chiva/Siguelineas/documentacion/imagenes/big/primerplano.JPG

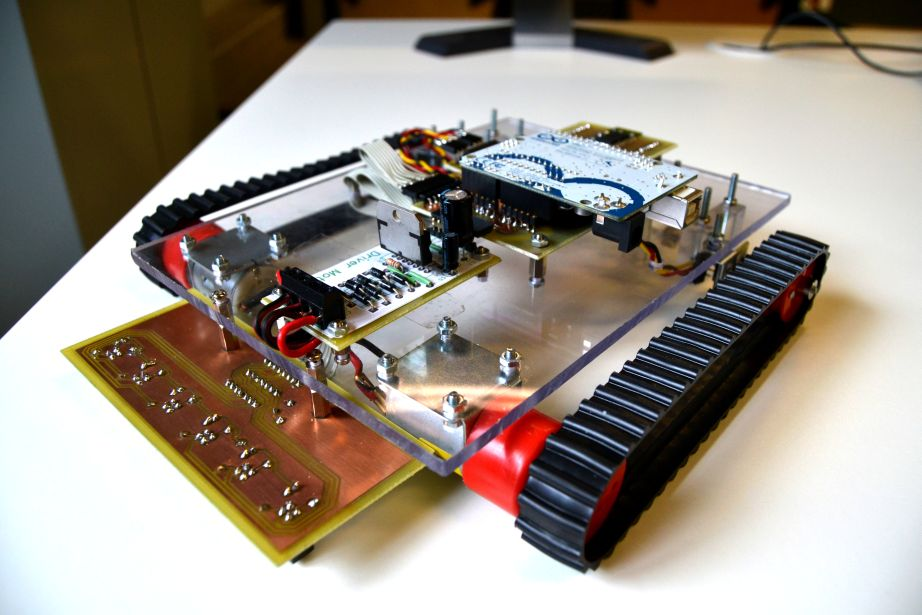
documentacion/imagenes/big/primerplano.JPG
