chiva/Siguelineas/documentacion/imagenes/big/driver.jpg

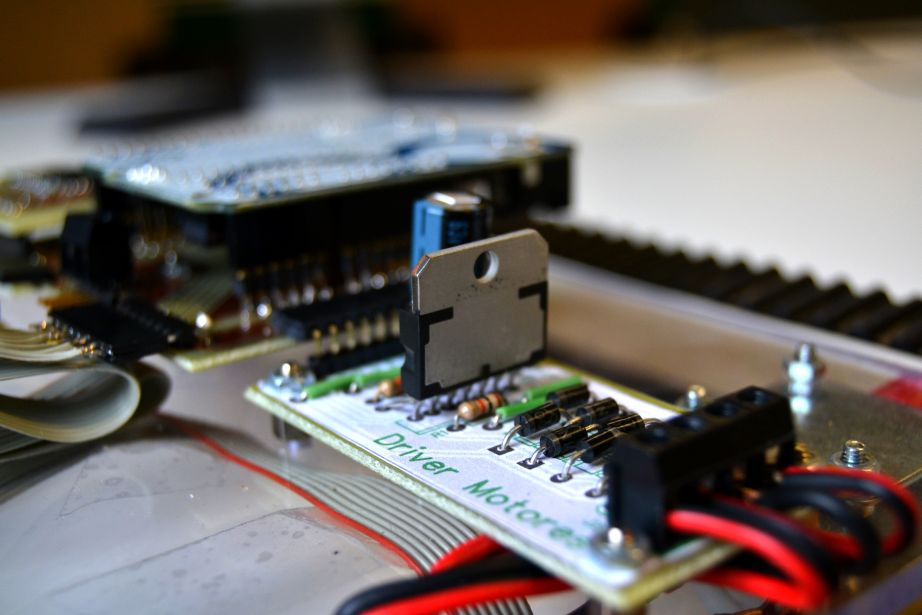
documentacion/imagenes/big/driver.jpg
