chiva/Siguelineas/documentacion/presentacion.pptx

## Robot orugas

Organización de Proyectos Final de Carrera

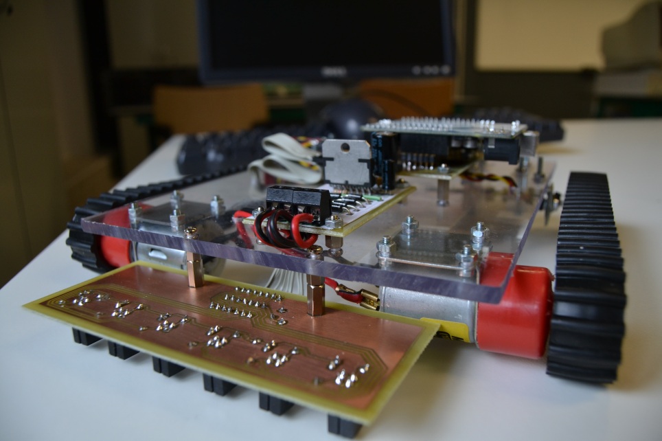
[picture p3: figure]

## Chasis y transmisión

Robot oruga

## Chasis y transmisión

- Partes mecánicas.
- Diseño compacto y sencillo.
- Materiales ligeros.
- Soporte para placas.

## Chasis y transmisión. Materiales

- Base de metacrilato.
- Orugas de goma.
- Ruedas de plástico.
- Tornillería.
- Placas al aire.

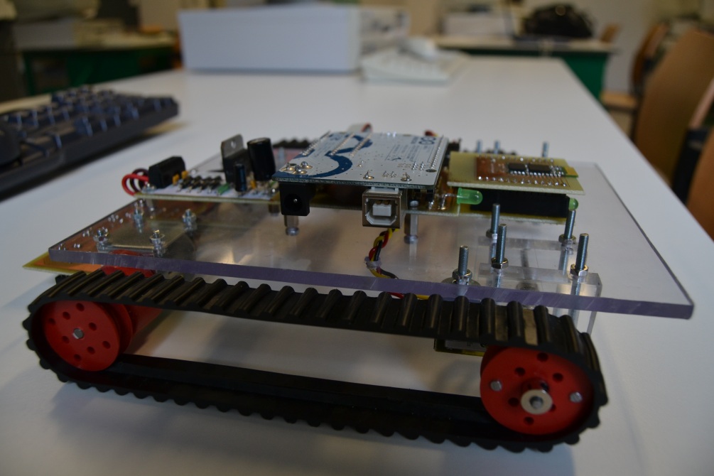
[picture p4: figure]

## Arduino

Robot orugas

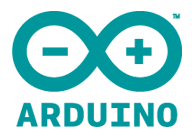
[picture p5: figure]
Arduino-logo

## Arduino

- Plataforma de desarrollo de prototipos.
- Versión: Arduino Uno R3.
  - Basado en ATmega 382.

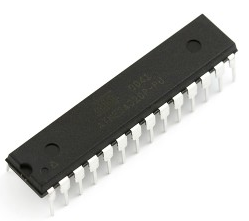
[picture p6: figure]

## Arduino. Características

- 14 E/S digitales (6 PWM).
- 6 Entradas analógicas.
- Conexión USB.
- Conector alimentación.
- Cabecera ICSP.
- Botón de RESET.

## Arduino. Esquema

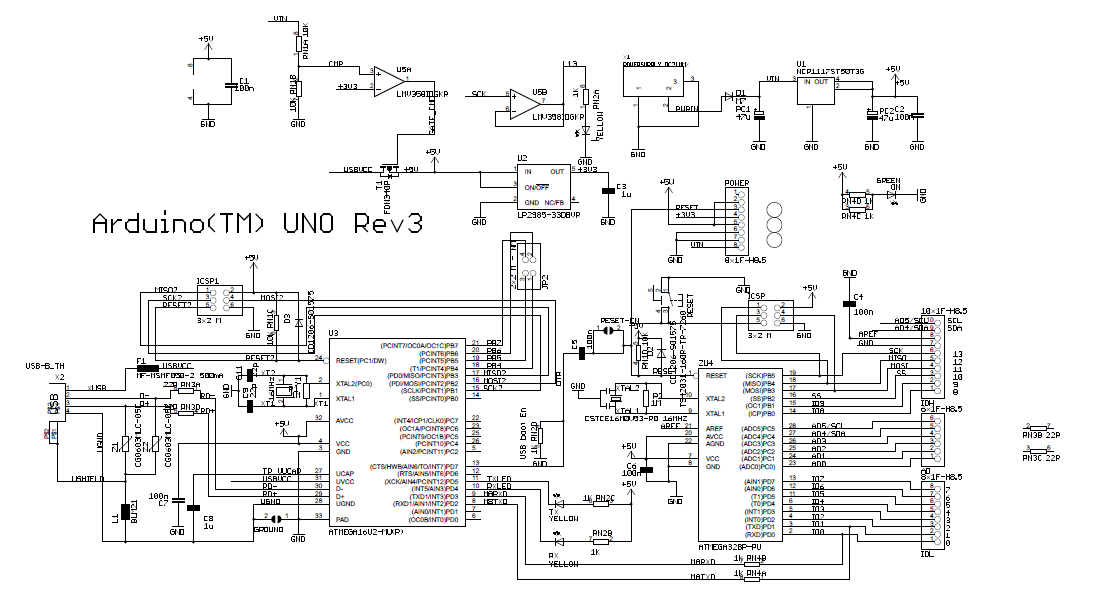
[picture p7: figure]

## Sensor CNY70

Robot orugas

## Sensor CNY70

- Sensor de corto alcance.
- Reflexión de luz.
- Lectura de línea y encoders relativos.

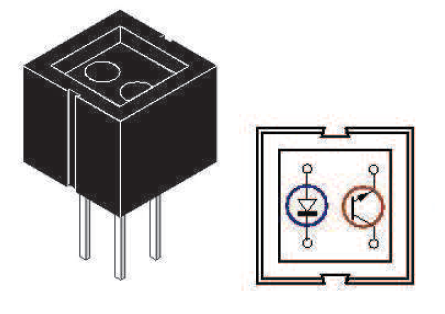
[picture p8: figure]

## Sensor CNY70. Encoders

- Encoders relativos.
- 12 divisiones.
- Realizados en AutoCad e impresos.

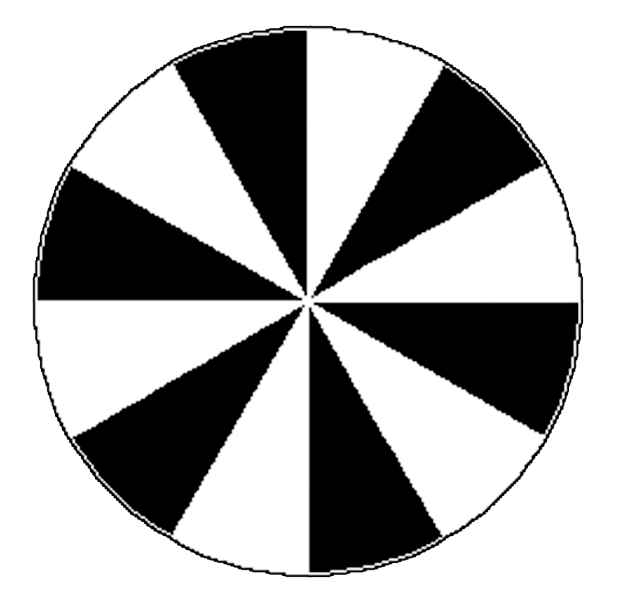
[picture p9: figure]
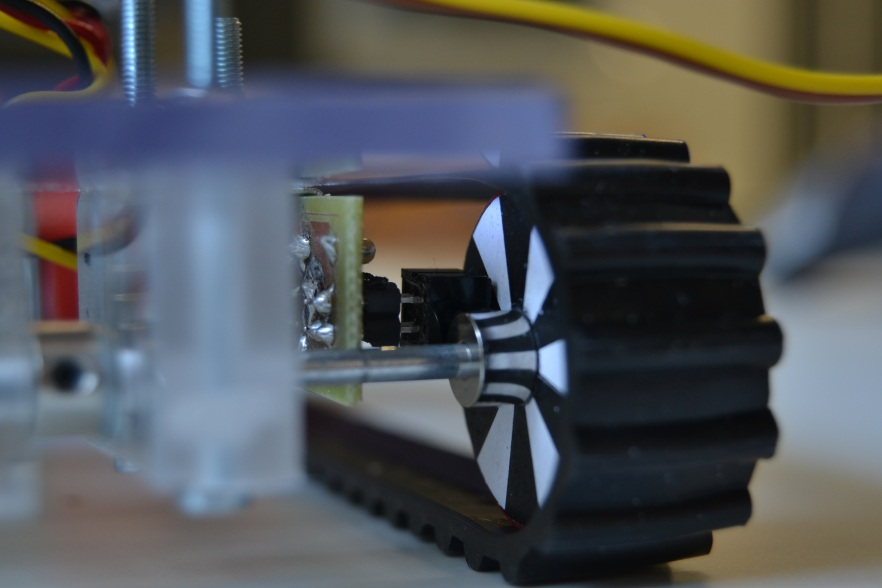
[picture p10: figure]

## Controlador proporcional

Robot orugas

## Sensores

Peso: -5 -3 -1 1 3 5

## Controlador

- Error proporcional
  - Sumatorio del peso de sensores activos
  - División entre el número de sensores activos
- Evitamos el uso de coma flotante

Error=(∑_(i=1)^n W_(sensor))/n

## Funcionamiento

-3

-1

1

Error=(−1+1)/2=0

Error=(−3−1)/2=−2

Error=(−1)/1=−1

## Driver motores

Robot oruga

## Driver motores

- Motor C-6065 de Fadisel
  - Consumo máximo: 0,85A a 3V (92 rpm).
- Driver Ls98N
  - Fácil adquisición y montaje.

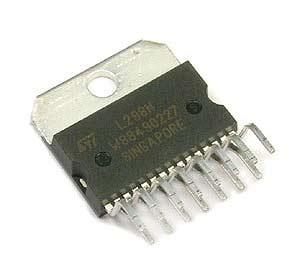
[picture p11: figure]

## Driver motores. Esquemático

  - Diodos protección.
  - Condensadores: almacenaje de picos y filtrado.

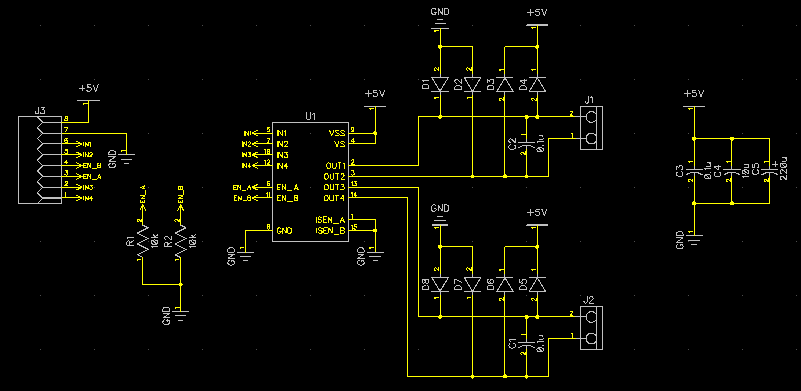
[picture p12: figure]

## Placa de comunicaciones Bluetooth

Robot orugas

## Placa de comunicaciones Bluetooth

- Conectar de forma remota con otros dispositivos.
- Una PCB para la colocación del módulo bluetooth.
- Otra PCB para conectarlo con Arduino.
- LED para comprobar el encendido.

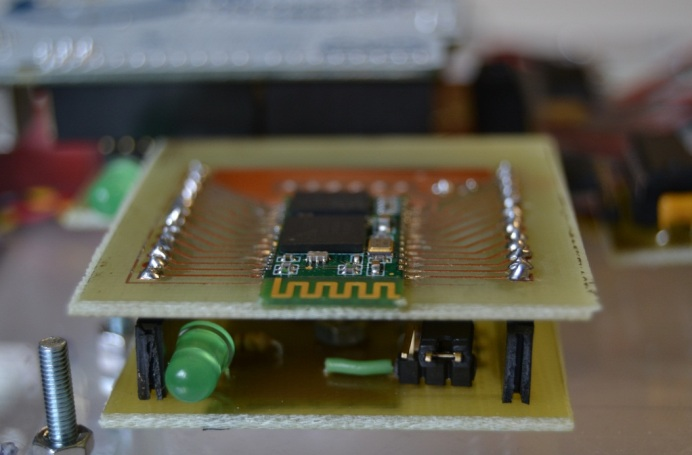
[picture p13: figure]

## Placa de conexiones

Robot orugas

## Placa de conexiones

- Interconexión Arduino-periféricos.

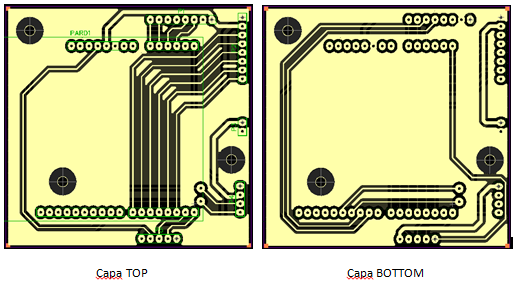
[picture p14: figure]

## Cargador baterías

Robot orugas

## Cargador baterías

- Basado en PIC
- Fuente de intensidad con LM317
- LEDs indicadores de estado
- Carga a corriente constante

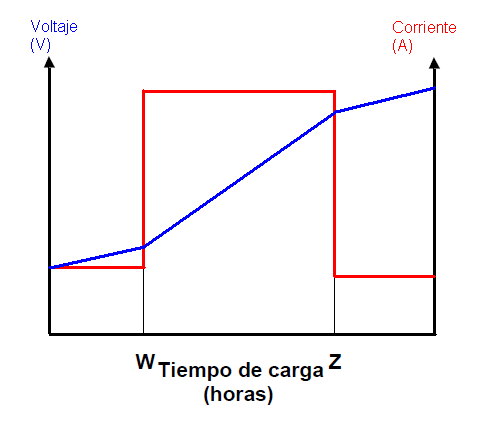
[picture p15: figure]

## Software utilizado

Robot orugas

## Software utilizado

- DIPTRACE.
- Software de programación Arduino.
- AutoCad 2012.
- OrCad (impresión PCB).
