chiva/Siguelineas/documentacion/imagenes/big/bluetooth.jpg

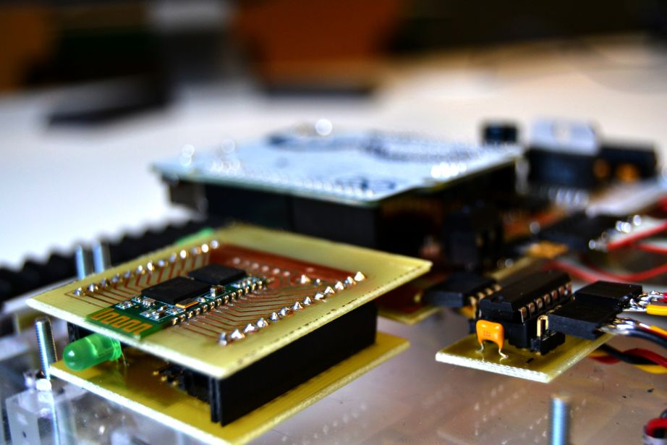
documentacion/imagenes/big/bluetooth.jpg
