chiva/Siguelineas/documentacion/imagenes/big/seguidor.JPG

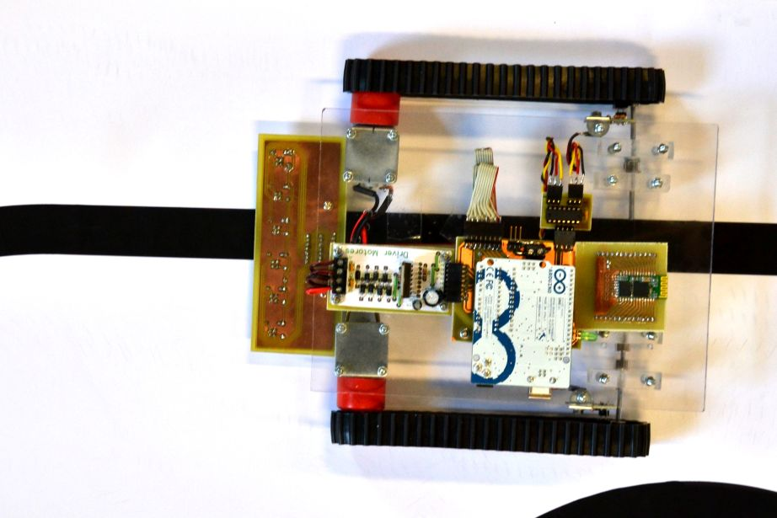
documentacion/imagenes/big/seguidor.JPG
