chiva/Siguelineas/esquematicos/comunicaciones/breakout.jpg

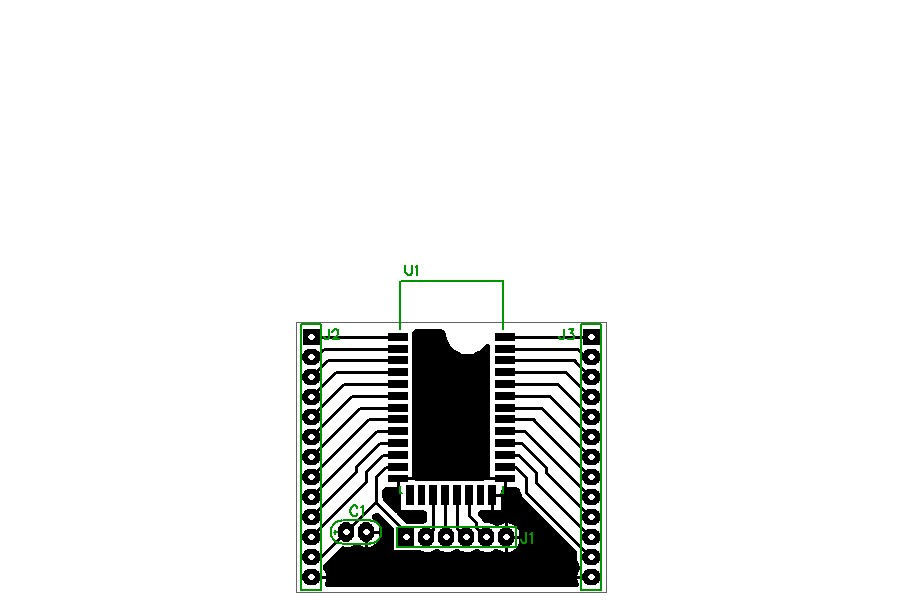
esquematicos/comunicaciones/breakout.jpg
