chiva/Siguelineas/esquematicos/comunicaciones/expansion.jpg

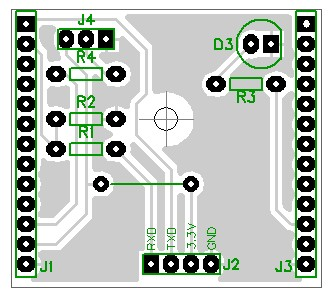
esquematicos/comunicaciones/expansion.jpg
