chiva/Siguelineas/esquematicos/deteccion linea/cny70.jpg

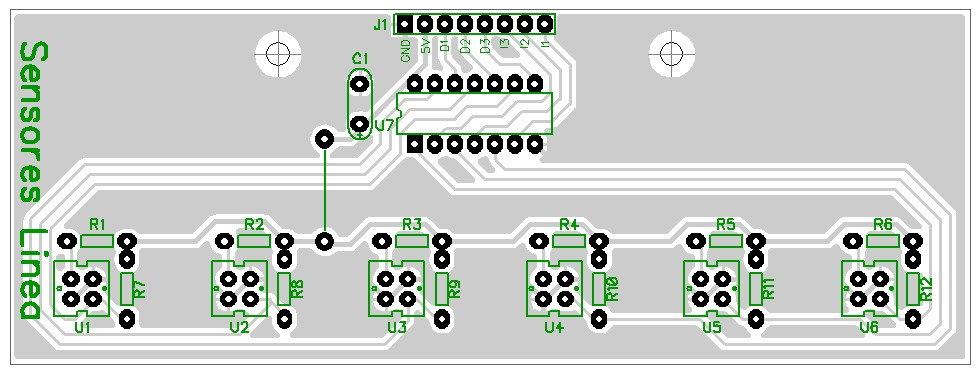
esquematicos/deteccion linea/cny70.jpg
