chiva/Siguelineas/esquematicos/driver motores/l298.jpg

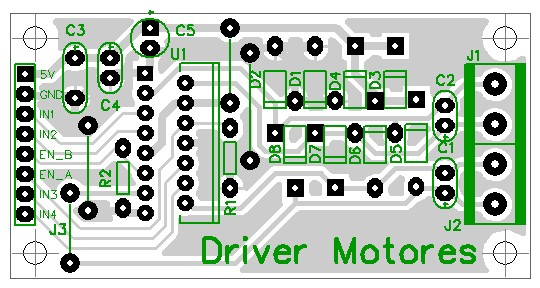
esquematicos/driver motores/l298.jpg
