chiva/Siguelineas/esquematicos/encoder rueda/conector.jpg

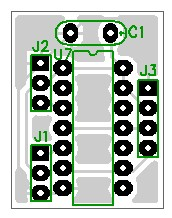
esquematicos/encoder rueda/conector.jpg
