chiva/Siguelineas/esquematicos/encoder rueda/encoder.jpg

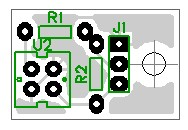
esquematicos/encoder rueda/encoder.jpg
