chiva/Siguelineas/esquematicos/principal/base.jpg

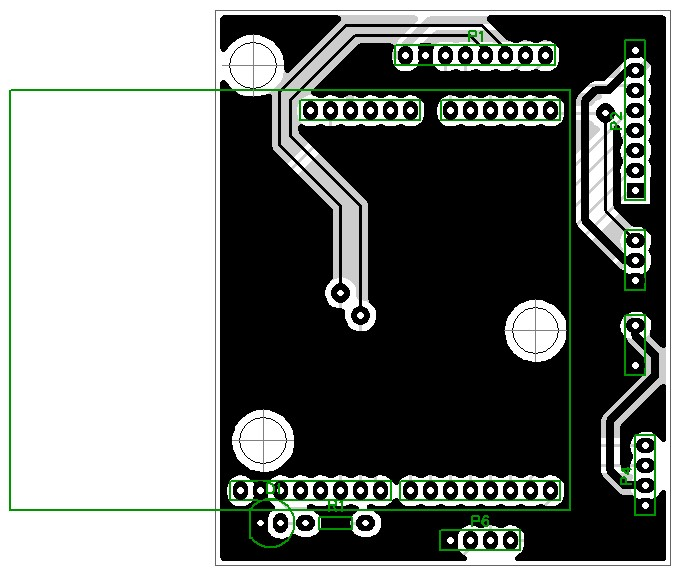
esquematicos/principal/base.jpg
