chiva/Siguelineas/(list of files, drawings)

Other design files:
esquematicos/comunicaciones/breakout.dch
esquematicos/comunicaciones/breakout.dip
esquematicos/comunicaciones/expansion.dch
esquematicos/comunicaciones/expansion.dip
esquematicos/deteccion linea/cny70.dch
esquematicos/deteccion linea/cny70.dip
esquematicos/driver motores/l298.dch
esquematicos/driver motores/l298.dip
esquematicos/encoder rueda/conector.dch
esquematicos/encoder rueda/conector.dip
esquematicos/encoder rueda/encoder.dch
esquematicos/encoder rueda/encoder.dip
esquematicos/principal/base.dip
