chiva/Siguelineas/(commit log)

2012-02-08 added L298 motor driver library
2012-02-20 mejorada libreria Motor298
2012-02-20 añadido libreria Driver298 de control de movimiento
2012-02-20 añadida libreria para Bluetooth
2012-02-20 iniciado el codigo principal del robot
2012-02-25 bluetooth: arreglado el no poder cambiar los parámetros
2012-03-01 linea: añadida libreria de seguimiento de linea
2012-03-01 robot: añadido codigo basico de seguimiento de linea
2012-03-10 linea: corregido comportamiento al perder la linea
2012-03-18 bluetooth: añadido tiempos de espera necesarios para comandos AT
2012-03-18 test: añadido test para sensores de línea
2012-03-28 encoder: añadida librería
2012-04-18 test: añadido test encoder
2012-04-23 camino: añadida libreria de seguimiento de caminos
2012-04-23 linea: añadido codigo especifico desde el principal
2012-04-23 encoder: ahora espera a que finalicen los movimientos
2012-04-24 linea: actualizados pines senor de linea
2012-04-24 encoder: test con actualizacion instantanea
2012-04-24 test: añadido test motores
2012-04-24 test: actualizacion de estado inmediata en encoder y linea
2012-04-24 camino: arreglado bug que no paraba las ruedas al alcanzar los pulsos establecidos
    [PathFollow.h, WheelEnc.h]
2012-04-24 camino: arreglado un par de bugs del anterior commit
    [PathFollow.h]
2012-04-24 test: mejorado test de motores
2012-05-02 test: mejorado test motores otra vez
2012-05-02 motor: cambiada inicializacion de motores a punteros
2012-05-08 camino: actualizado pasos para giro
2012-05-08 robot: actualizado pines control de motores
2012-05-08 test: unificados test de motores
2012-05-09 camino: arreglado no paro de motores y ajuste de giro
    [PathFollow.h]
2012-05-18 añadidos esquematicos y datasheets
    [base.dip, breakout.dch, breakout.dip, cny70.dch, cny70.dip, conector.dch, conector.dip, encoder.dch]
2012-05-25 robot: para motor al volver al menú
2012-05-25 camino: arreglado bug crítico
    [PathFollow.h]
